dmcke5/Hapticpad/(commit log)

2026-01-09 Updated Motor Assembly Drawing
2026-01-10 Added PCB's
    [MacroPad Controller Board.kicad_pcb, MacroPad Controller Board.kicad_sch, MacroPad.kicad_pcb, MacroPad.kicad_sch]
2026-01-13 Update tactile button information in README
    Added alternative tactile button options and shipping note.
2026-01-13 Fix typo in README for alternative tactile buttons
